HydroPWNics/SunLeaf/img/SunLeaf0.2a3D.png

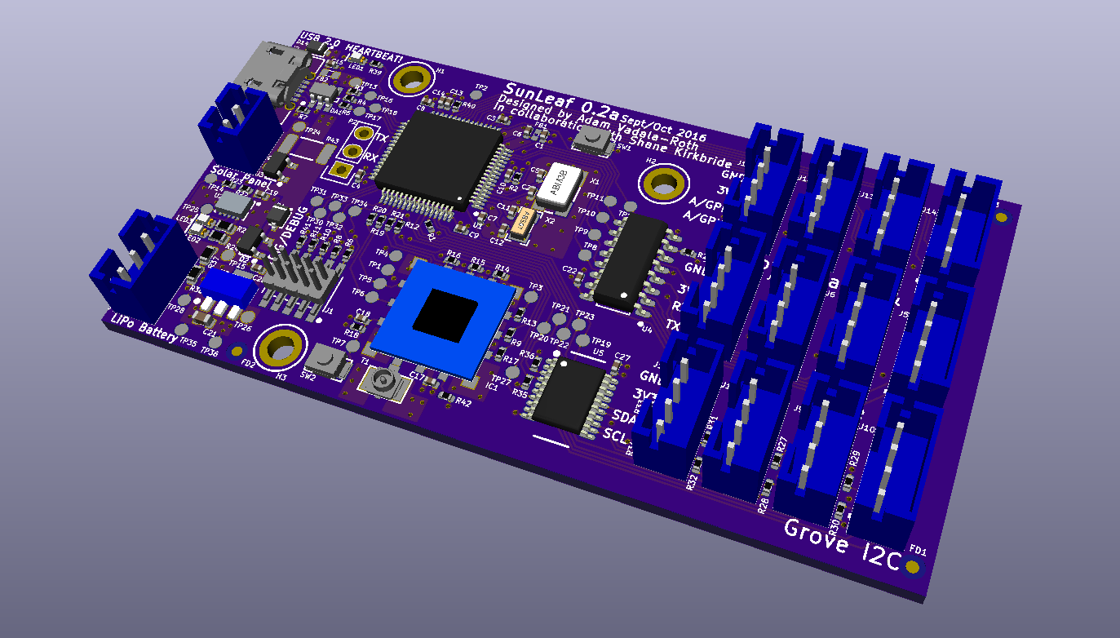
img/SunLeaf0.2a3D.png
