HydroPWNics/SunLeaf/img/SunLeaf0.1aFab.JPG

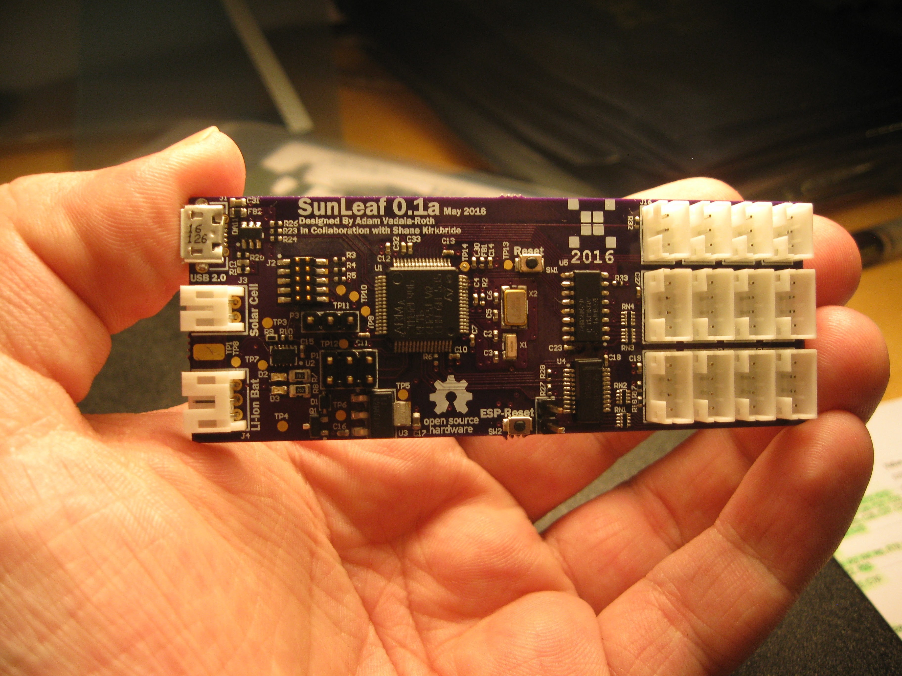
img/SunLeaf0.1aFab.JPG
