HydroPWNics/SunLeaf/README.md

# SunLeaf
SunLeaf is a WiFi based remote sensor module, interfaces with I2C and UART sensors, pushes directly to the cloud.
