HydroPWNics/SunLeaf/Datasheet/PSF-A85_Schmatic.png

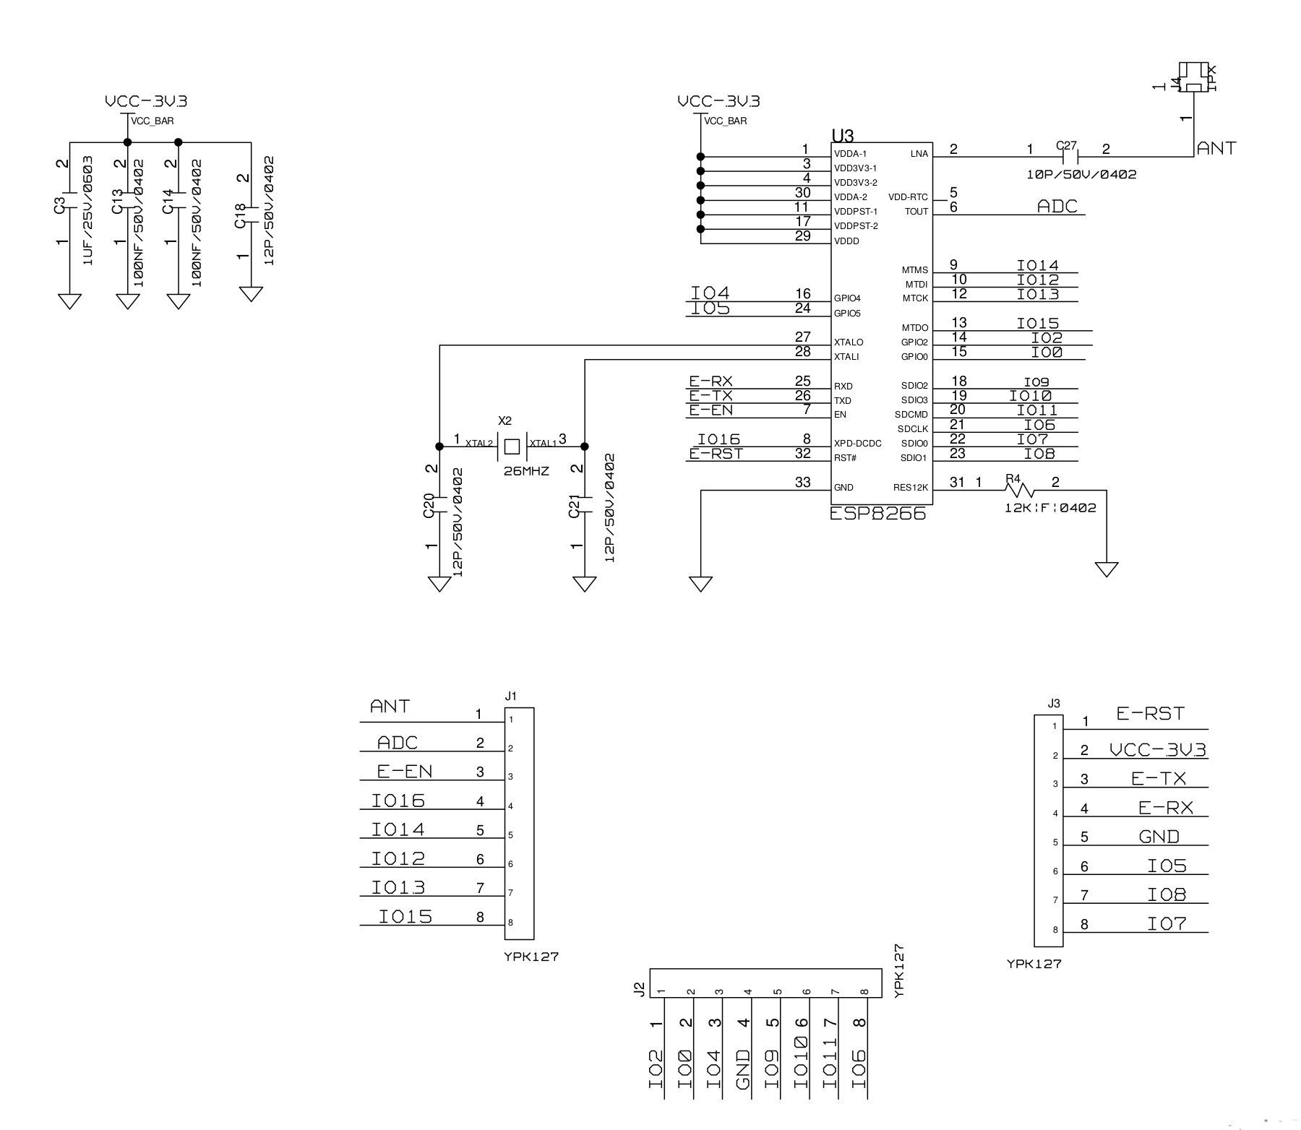
Datasheet/PSF-A85_Schmatic.png
