HydroPWNics/SunLeaf/img/IMG_3619.JPG

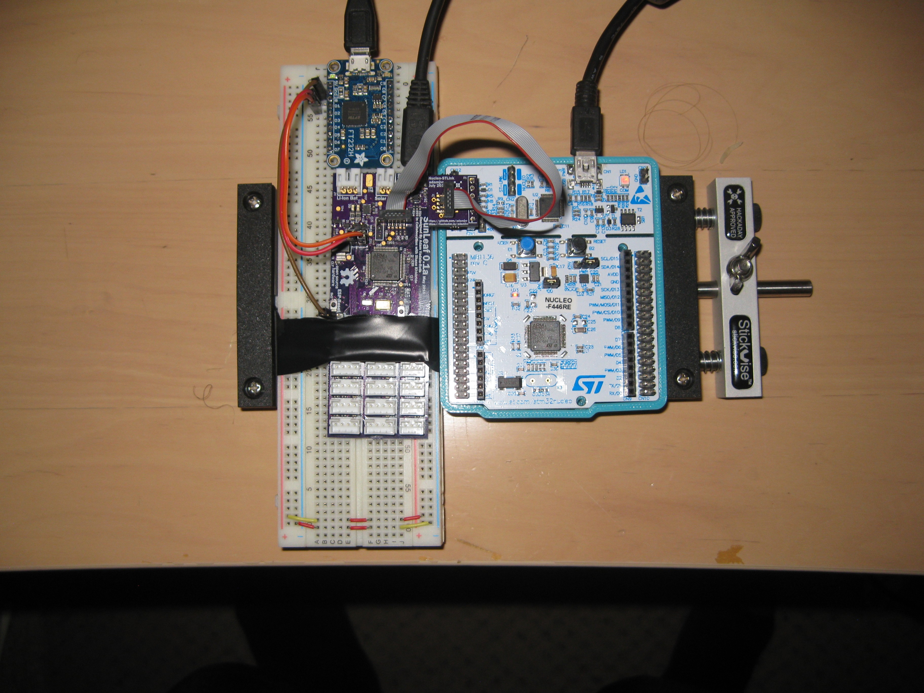
img/IMG_3619.JPG
