HydroPWNics/SunLeaf/img/SunLeaf0.1a.png

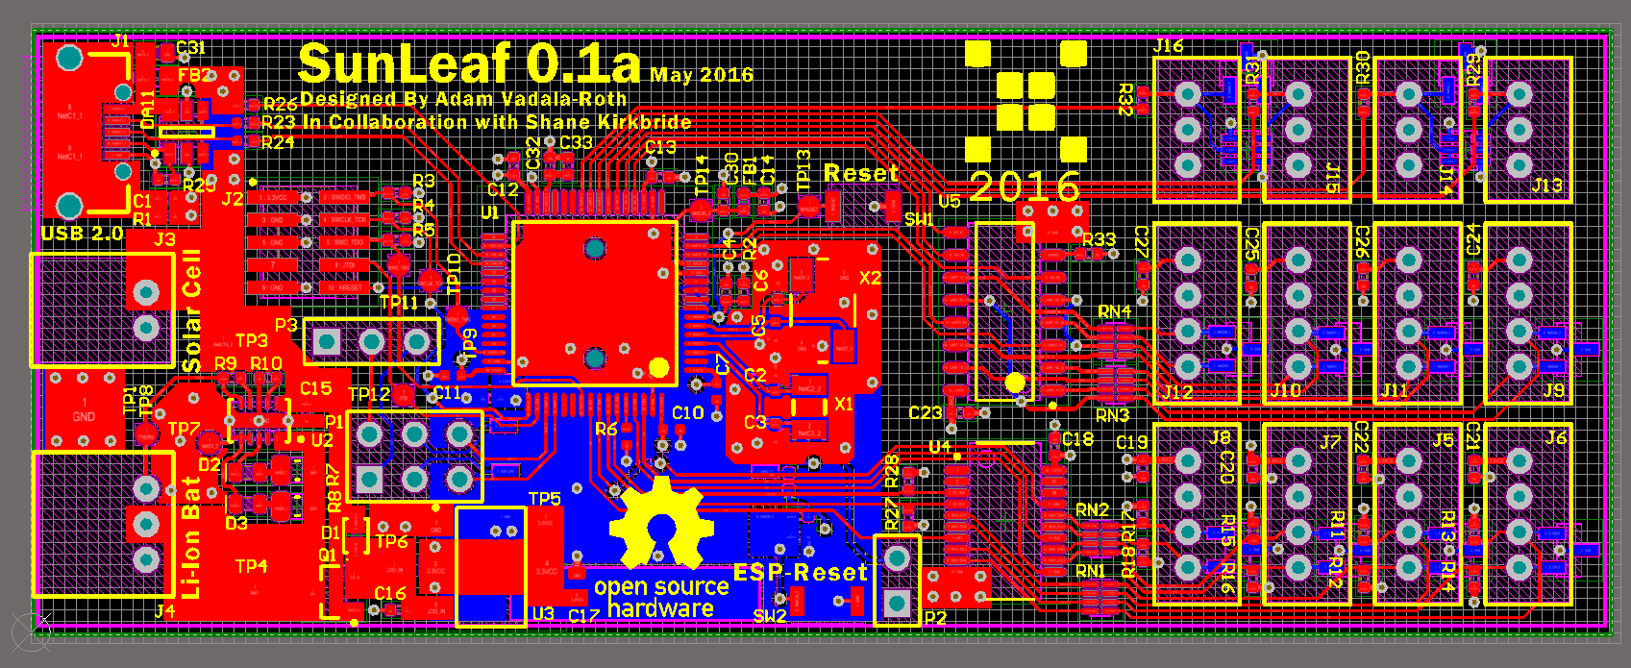
img/SunLeaf0.1a.png
