HydroPWNics/SunLeaf/img/SunLeaf0.2a2D.png

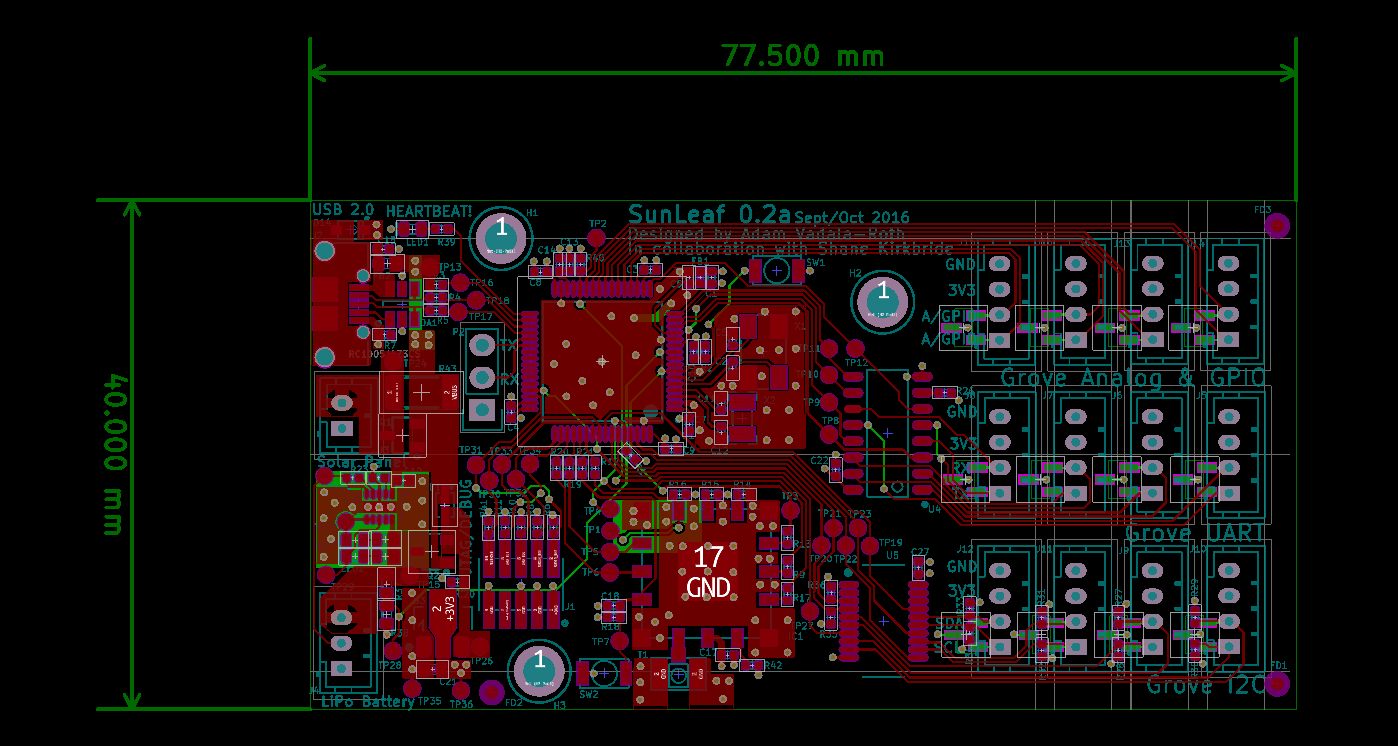
img/SunLeaf0.2a2D.png
