HydroPWNics/SunLeaf/img/SunLeaf0.2a_OSHPAR_bottom.png

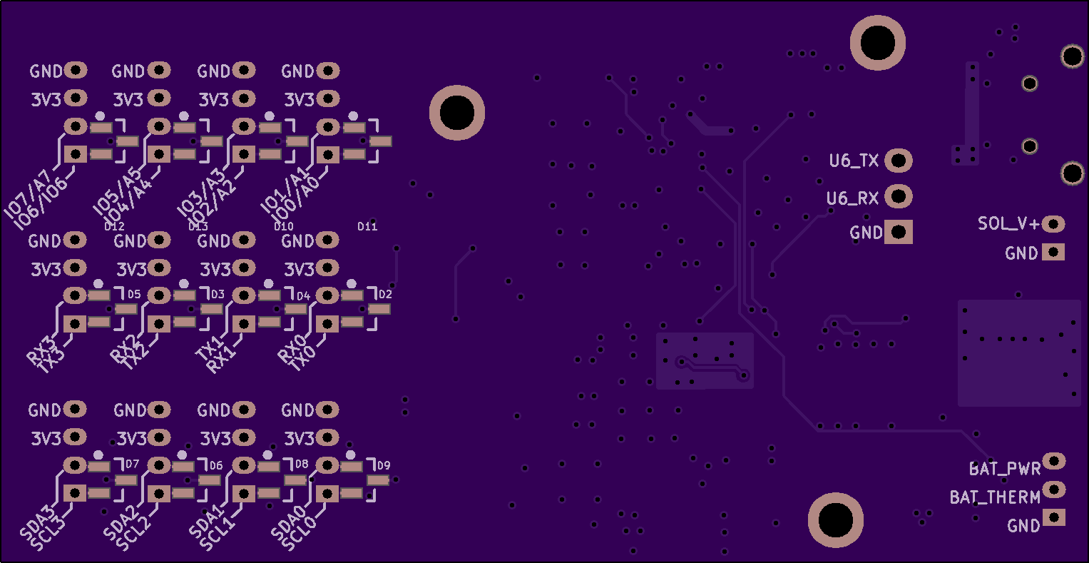
img/SunLeaf0.2a_OSHPAR_bottom.png
