HydroPWNics/SunLeaf/img/SunLeaf0.2a_OSHPAR_top.png

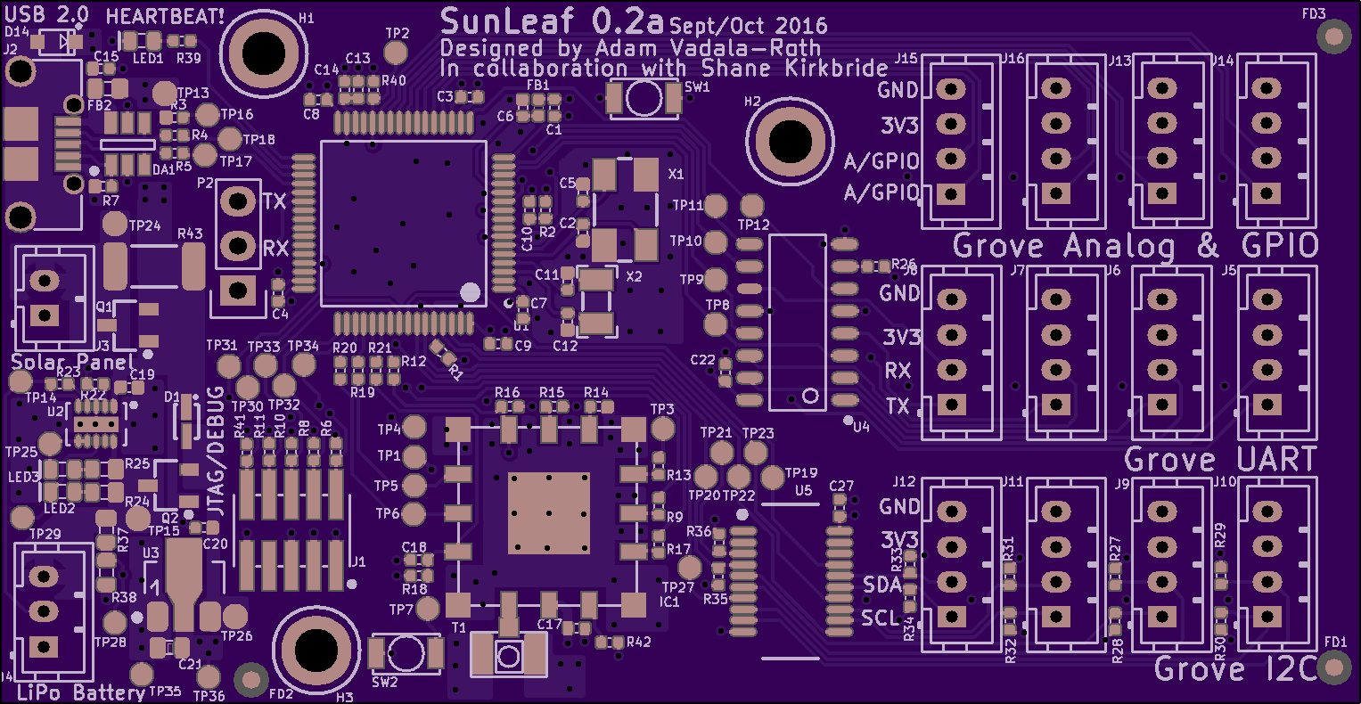
img/SunLeaf0.2a_OSHPAR_top.png
