HydroPWNics/SunLeaf/img/SunLeaf_block.png

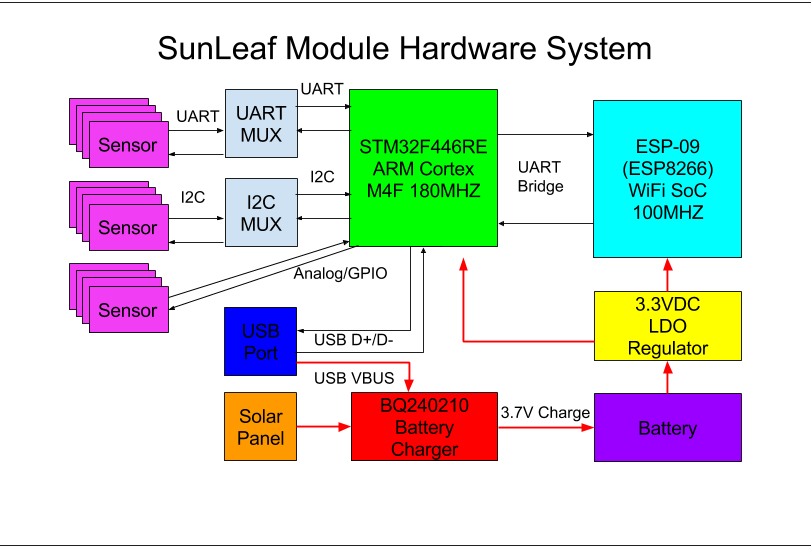
img/SunLeaf_block.png
