HydroPWNics/SunLeaf/PCB V2.1/Schematic Renders/ANA_GPIO.png

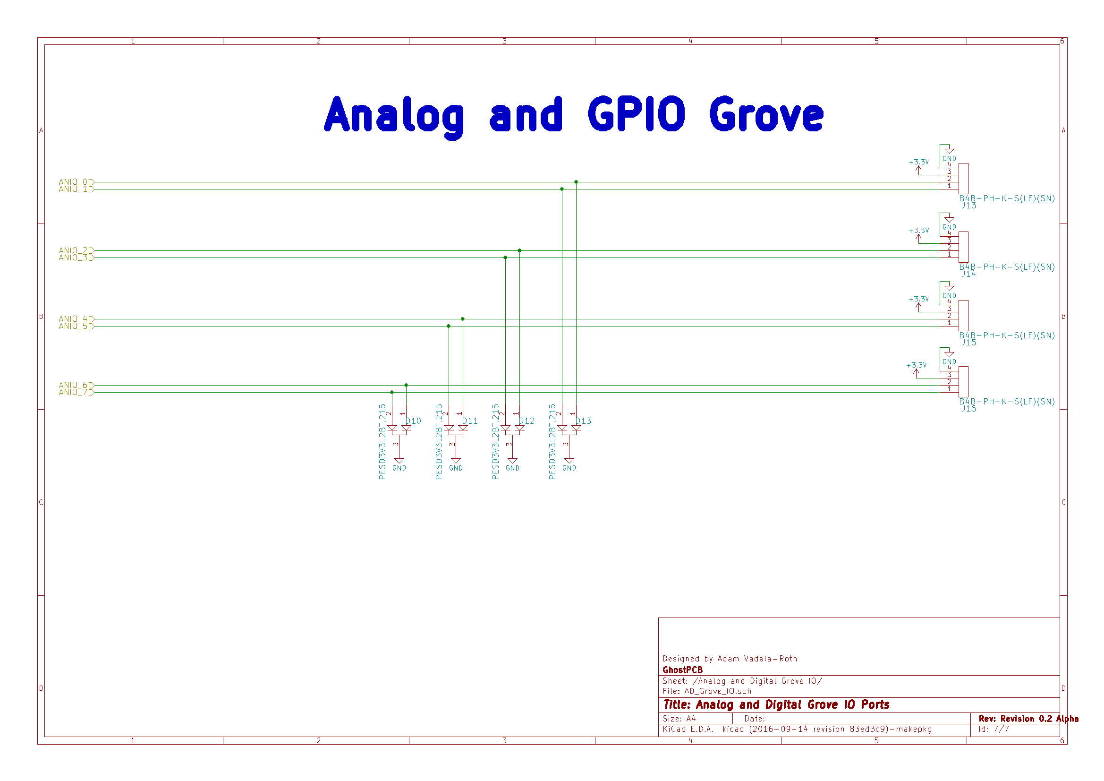
PCB V2.1/Schematic Renders/ANA_GPIO.png
