HydroPWNics/SunLeaf/PCB V2.1/Schematic Renders/BAT_PWR.png

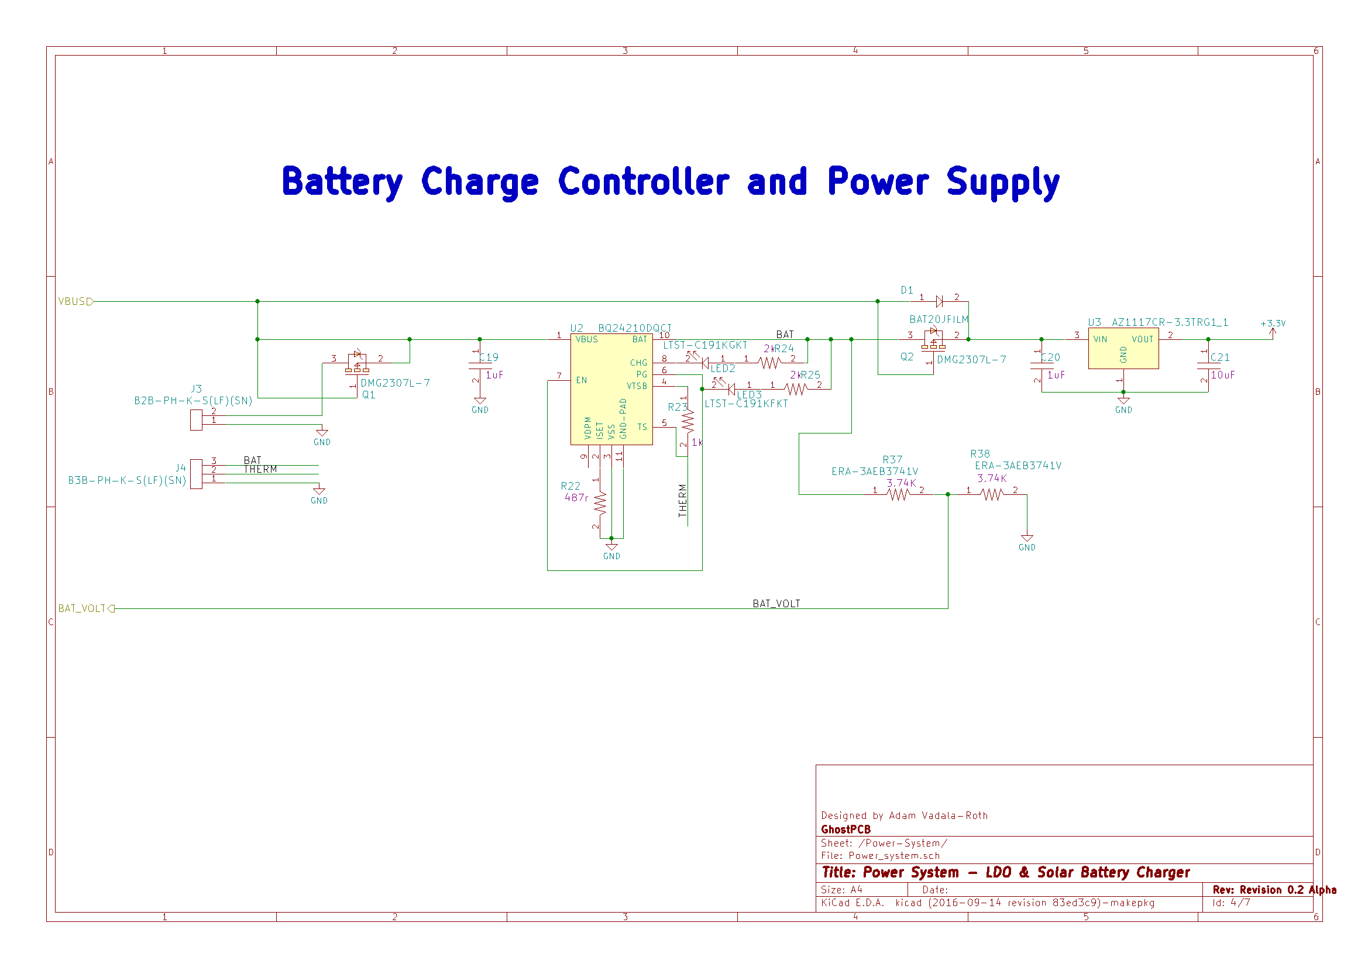
PCB V2.1/Schematic Renders/BAT_PWR.png
