HydroPWNics/SunLeaf/PCB V2.1/Schematic Renders/ESP-09.png

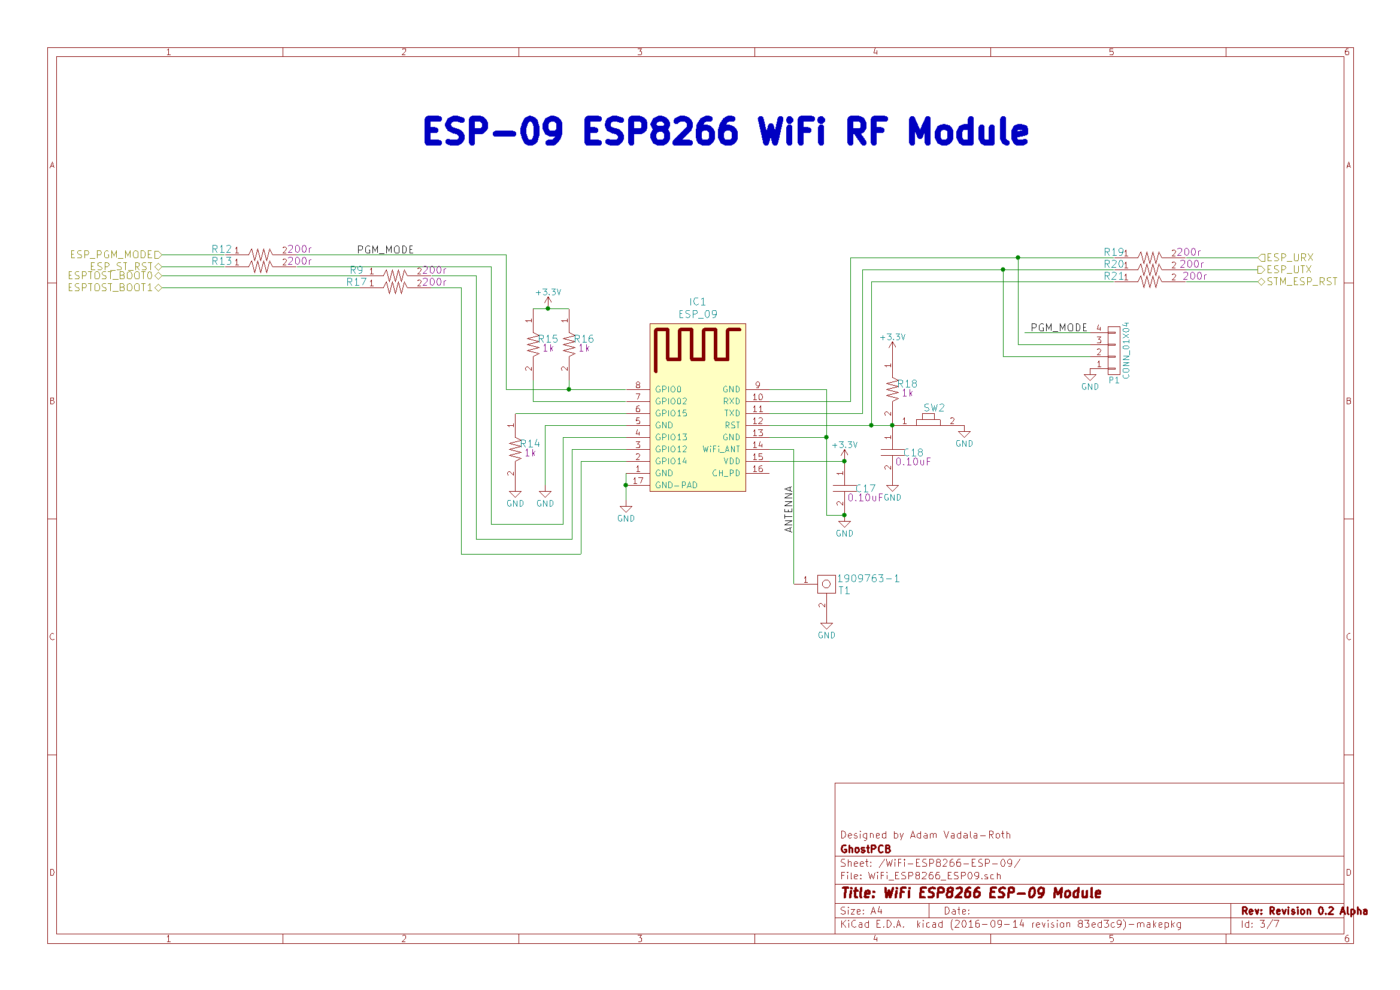
PCB V2.1/Schematic Renders/ESP-09.png
