HydroPWNics/SunLeaf/PCB V2.1/Schematic Renders/I2C_S.png

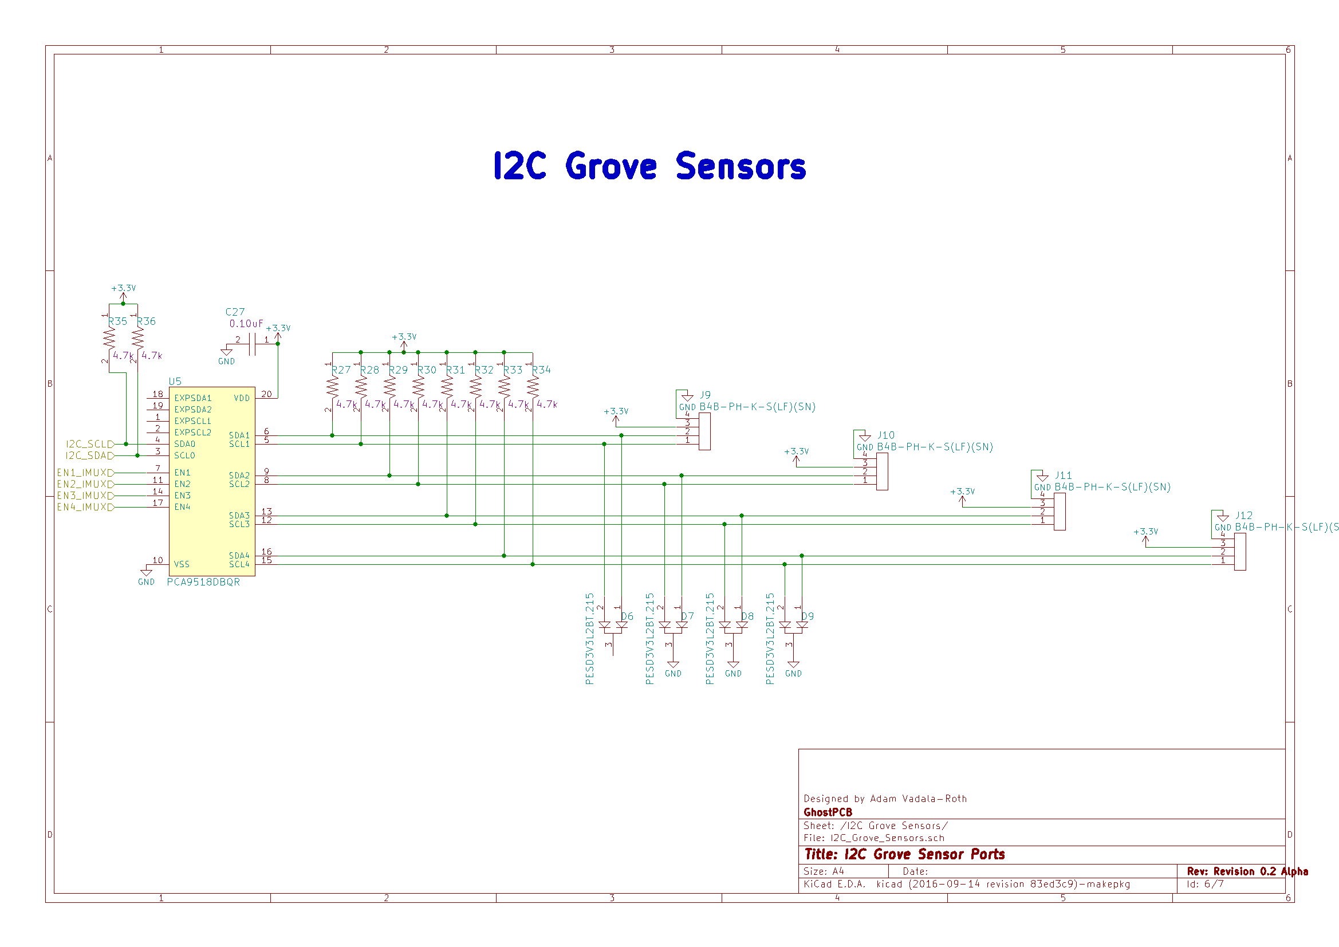
PCB V2.1/Schematic Renders/I2C_S.png
