HydroPWNics/SunLeaf/PCB V2.1/Schematic Renders/STM32.png

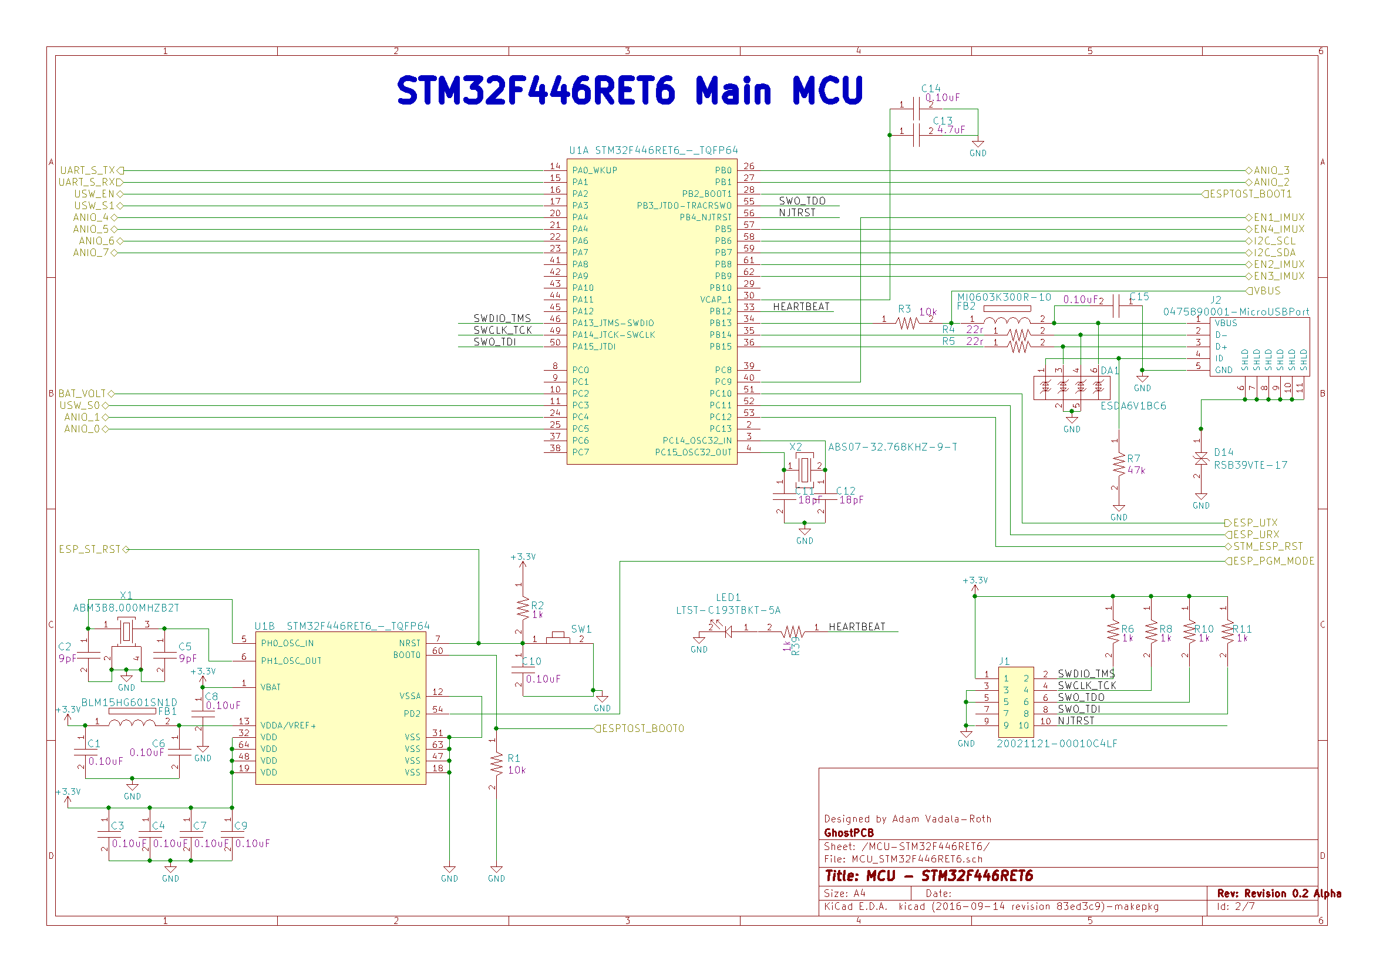
PCB V2.1/Schematic Renders/STM32.png
