HydroPWNics/SunLeaf/PCB V2.1/Schematic Renders/SystemOV.png

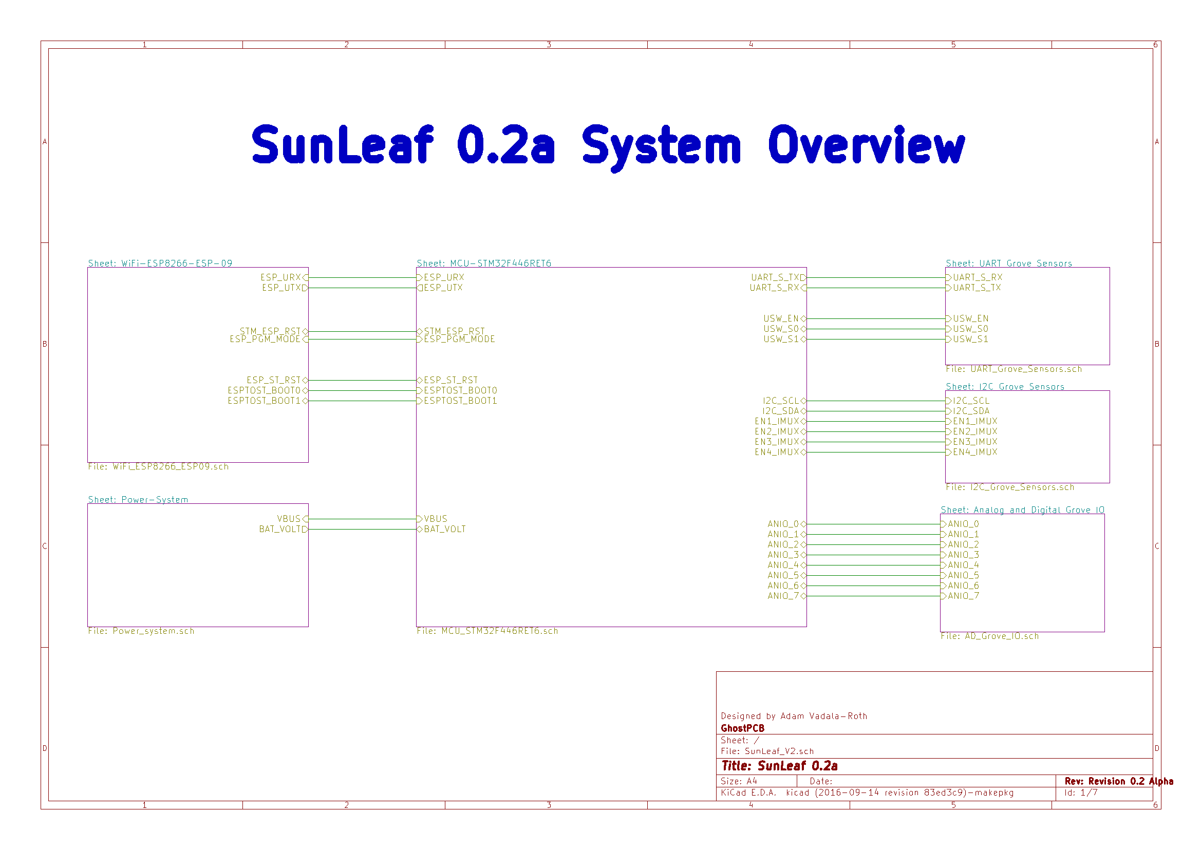
PCB V2.1/Schematic Renders/SystemOV.png
