HydroPWNics/SunLeaf/PCB V2.1/Schematic Renders/UART_S.png

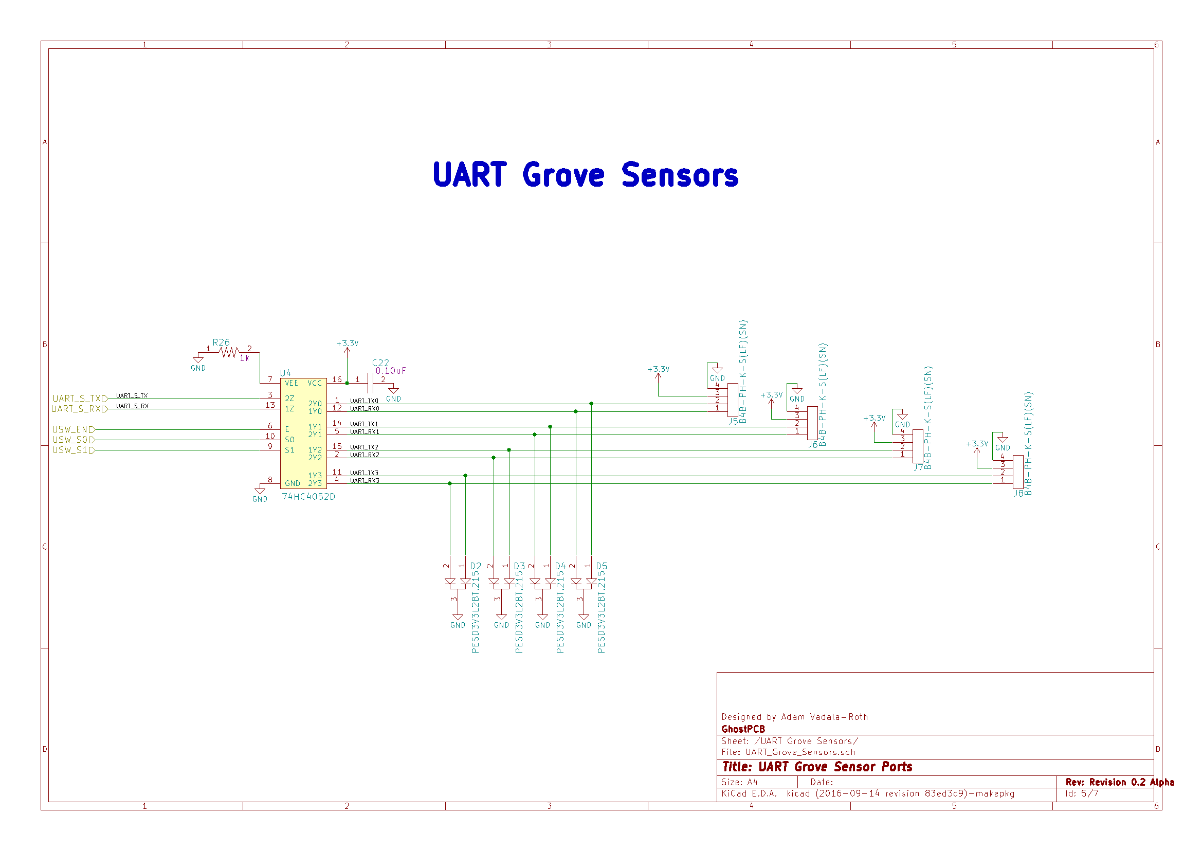
PCB V2.1/Schematic Renders/UART_S.png
