HydroPWNics/SunLeaf/(commit log)

2016-03-31 Footprints and Schematic
    Preliminary footprint creation for new MCU completed. Schematic nearly
    finished currently working on the STM32 section all others are done save
    for some ESD supression on the sensor connectors.
    [MCU - STM32F446RET6.SchDoc, Power.SchDoc, Sensors - I2C_Grove.SchDoc, Sensors - UART_Grove.SchDoc, Sensors_WiFi.SchDoc, SunLeaf.PrjPcb, System.SchDoc, WiFi - ESP8266 SoC.SchDoc]
2016-04-03 Schematic Near COmplete
    All left is connecting subsystems to STM32F4 and finishign the USB
    circuit.
    [MCU - STM32F446RET6.SchDoc, Power.SchDoc, Sensors - I2C_Grove.SchDoc, Sensors - UART_Grove.SchDoc, SunLeaf.PrjPcb, System.SchDoc, WiFi - ESP8266 SoC.SchDoc]
2016-04-07 Schematic Finished Board Started
    Schematic complete but subject to change and PCB started.
    [MCU - STM32F446RET6.SchDoc, Power.SchDoc, Sensors - I2C_Grove.SchDoc, Sensors - UART_Grove.SchDoc, SunLeaf.PcbDoc, SunLeaf.PrjPcb, System.SchDoc, WiFi - ESP8266 SoC.SchDoc]
2016-04-08 PCB Progress
    More progress on PCB, bottom mounting all ESD components on grove
    sensors.
    [MCU - STM32F446RET6.SchDoc, Sensors - I2C_Grove.SchDoc, Sensors - UART_Grove.SchDoc, SunLeaf.PcbDoc, SunLeaf.PrjPcb]
2016-04-11 Board Progress
    Board progressing along, schematic for I2C and UART connectors pin
    swapped for correct pinout.
    [Sensors - I2C_Grove.SchDoc, Sensors - UART_Grove.SchDoc, SunLeaf.PcbDoc]
2016-04-27 Board
    Lots of progress with the PCB, size increased to 1.25 X 3.5 inches to
    better fit circuitry and allow for an adequate keep out layer. Expansion
    connectors are being added but highly subject to change a few times
    before finalizing. The ESP-02 module's UART signals are jumperable to
    connect it to either the STM32 or a programming pin header. Discussing
    with Shane about further improvements and ESD suppression.
    [MCU - STM32F446RET6.SchDoc, Sensors - I2C_Grove.SchDoc, Sensors - UART_Grove.SchDoc, SunLeaf.PcbDoc, SunLeaf.PrjPcb, WiFi - ESP8266 SoC.SchDoc]
2016-04-29 Nearing COmpletion
    Added graphics for designer credit, hackaday prize, and open hardware.
    Still working out expansion headers.
    [MCU - STM32F446RET6.SchDoc, SunLeaf.PcbDoc, SunLeaf.PrjPcb]
2016-05-02 Done
    Board finished, awaiting discussion with Shane
    [Expansion & Analog.SchDoc, MCU - STM32F446RET6.SchDoc, SunLeaf.PcbDoc, SunLeaf.PrjPcb, System.SchDoc]
2016-05-05 Board CHanges
    Shielding copper pour tied to ground for the ESP-02 module added.
    Routing adjusted and cleaned up. Alligator clip test point added for
    scope probe grounding.
    [MCU - STM32F446RET6.SchDoc, Power.SchDoc, SunLeaf.PcbDoc]
2016-05-06 Test Points and Cleanup
    Errors cleaned up (unrouted nets etc), test points added. More to
    follow.
    [Expansion & Analog.SchDoc, MCU - STM32F446RET6.SchDoc, Power.SchDoc, Sensors - I2C_Grove.SchDoc, Sensors - UART_Grove.SchDoc, SunLeaf.PcbDoc, WiFi - ESP8266 SoC.SchDoc]
2016-05-09 Schematic Review and Change
    Shematic went under futher review, additional cap added to VCAP pin and
    other pins tied GND instead of though caps, misunderstanding of the
    Nucleo schematic vs. datasheet spec.
    [MCU - STM32F446RET6.SchDoc, SunLeaf.PcbDoc]
2016-05-24 Design Finished and Off To Fab
    Design now frozen in place for prototype 1 fabrication, assembly and
    test. The libraries saw a massive cleanup, the USB section redesigned
    with the correct signal order! 3D step file included, and OSHPark order
    files.
    [MCU - STM32F446RET6.SchDoc, Power.SchDoc, Sensors - I2C_Grove.SchDoc, Sensors - UART_Grove.SchDoc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]
2016-06-05 3D Fixes
    Component with incorrect Z axis offset, fixed and 3D model accurately
    regenerated.
    [SunLeaf.PcbDoc, WiFi - ESP8266 SoC.SchDoc]
2016-08-08 Nucleo-STLink
    fully completed project for a PCB adapter for the ST Nucleo board's
    programming header. adapts the 6 pin SWD header to a ARM Cortex M debug
    header.
    [Nucleo-STLink.PcbDoc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]
2016-08-22 V2 begun
    Version 2 and KiCAD port started
    [AD_Grove_IO.sch, Expansion & Analog.SchDoc, I2C_Grove_Sensors.sch, MCU - STM32F446RET6.SchDoc, MCU_STM32F446RET6.sch, Power.SchDoc, Power_system.sch, SunLeaf.PcbDoc]
2016-09-09 SunLeaf Alpha 0.2 and KiCAD Port
    SunLeaf rev 2 called Alhpa 0.2 or 0.2a is the main component of this
    commit. The entire hardware project has been ported to KiCAD libaries
    and all. 0.2a features a revised formfactor, better ESP module, and many
    fixes over the original. This version will also be capable of OTA
    updates.
    [AD_Grove_IO.sch, Expansion & Analog.SchDoc, I2C_Grove_Sensors.sch, MCU - STM32F446RET6.SchDoc, MCU_STM32F446RET6.sch, Power.SchDoc, Power_system.sch, SunLeaf.PcbDoc]
2016-09-09 Update
    Updating KiCAD to the latest to get rounded corner pad support, filing
    this commit as a backup of the project before update.
    [AD_Grove_IO.sch, I2C_Grove_Sensors.sch, MCU_STM32F446RET6.sch, Power_system.sch, UART_Grove_Sensors.sch, WiFi_ESP8266_ESP09.sch]
2016-09-17 Placement
    Heavy progress on component placement in KiCAD for SunLEaf V2,
    committing to save progress, nightly builds of KiCAD are very crash
    prone.
    [AD_Grove_IO.sch, I2C_Grove_Sensors.sch, MCU_STM32F446RET6.sch, Power_system.sch, SunLeaf_V2.kicad_pcb, UART_Grove_Sensors.sch, WiFi_ESP8266_ESP09.sch, _saved_AD_Grove_IO.sch]
2016-09-17 Placement near completeq
    placement is near complete, saving as revision, remember KiCAD=crash
    [AD_Grove_IO.sch, I2C_Grove_Sensors.sch, UART_Grove_Sensors.sch, _saved_AD_Grove_IO.sch, _saved_I2C_Grove_Sensors.sch]
2016-09-17 Revert "Placement near completeq"
    This reverts commit ae7bce2a0b52adb9ec10d03d9117548a28df5835.
    [SunLeaf_V2.kicad_pcb, UART_Grove_Sensors.sch, _saved_AD_Grove_IO.sch, _saved_I2C_Grove_Sensors.sch]
2016-09-17 Placement progress
    Placement is 99% done board is being resized. Next commit TVS diode
    pairs will be fliped and the baord further resized.
    [AD_Grove_IO.sch, I2C_Grove_Sensors.sch, SunLeaf_V2.kicad_pcb, UART_Grove_Sensors.sch]
2016-09-17 Routing and Placement
    Placement complete routing has begun. The board size has also been
    solidified.
    [MCU_STM32F446RET6.sch, SunLeaf_V2.kicad_pcb, _saved_AD_Grove_IO.sch, _saved_I2C_Grove_Sensors.sch]
2016-09-17 Routing Progress
    Routing progress made, UART and I2C sensors routed, ESP routed, power
    section and solar batter routed, USB routed.
    [MCU_STM32F446RET6.sch, SunLeaf_V2.kicad_pcb, UART_Grove_Sensors.sch]
2016-09-17 Route 99%
    PCB routing at 99%, next commit complete route and internal layers.
    [SunLeaf_V2.kicad_pcb]
2016-09-17 Internal Planes
    Internal Planes added, small amount of routing left.
    [AD_Grove_IO.sch, I2C_Grove_Sensors.sch, MCU_STM32F446RET6.sch, Power_system.sch, SunLeaf_V2.kicad_pcb, SunLeaf_V2.sch, UART_Grove_Sensors.sch, WiFi_ESP8266_ESP09.sch]
2016-09-17 PDF
    Schematic PDF updated.
    [SunLeaf_V2.kicad_pcb]
2016-09-18 Workstation Switch
    Switching to laptop, syncing files.
    [SunLeaf_V2.kicad_pcb]
2016-09-19 OTA
    This commit contains adjustments to the schematics for over the air
    update/programming of STM32 via the ESP8266 using its internal
    bootloader. The two processors have been wired together to suppor this
    fucntions, they can toggle reset of eachother and load firmware over
    UART. Still deciding what reset signal pin on the STM32 to use fo rthis
    purpose, next commit.
    [AD_Grove_IO.sch, I2C_Grove_Sensors.sch, MCU_STM32F446RET6.sch, Power_system.sch, SunLeaf_V2.kicad_pcb, SunLeaf_V2.sch, UART_Grove_Sensors.sch, WiFi_ESP8266_ESP09.sch]
2016-09-19 Battery Monitoring & OTA
    OTA signals between both processors solidified and routed. Battery
    monitoring added as voltage divider into ADC channel. All but done
    pending some small tweaks.
    [AD_Grove_IO.sch, I2C_Grove_Sensors.sch, MCU_STM32F446RET6.sch, Power_system.sch, SunLeaf_V2.sch, UART_Grove_Sensors.sch, WiFi_ESP8266_ESP09.sch]
2016-09-21 App Notes
    App notes added to datasheets folder.
    [AD_Grove_IO.sch, I2C_Grove_Sensors.sch, MCU_STM32F446RET6.sch, Power_system.sch, SunLeaf_V2.kicad_pcb, UART_Grove_Sensors.sch, WiFi_ESP8266_ESP09.sch]
2016-09-23 DRC Clearing
    More DRC errors cleared. Getting board ready for fab.
    [AD_Grove_IO.sch, I2C_Grove_Sensors.sch, MCU_STM32F446RET6.sch, Power_system.sch, SunLeaf_V2.kicad_pcb, UART_Grove_Sensors.sch, WiFi_ESP8266_ESP09.sch]
2016-09-26 DRC clear
    all design rule violations cleared.
    [MCU_STM32F446RET6.sch, SunLeaf_V2.kicad_pcb]
2016-09-29 3D and Tweaks
    3D files added for components for proper 3D rneder of the board. Board
    tweaked, additional ground pours and sticking under neath the ESP-09,
    cleaned up routign of JTAG , added labeling of all the pin signals.
    [AD_Grove_IO.sch, I2C_Grove_Sensors.sch, MCU_STM32F446RET6.sch, Power_system.sch, SunLeaf_V2.kicad_pcb, UART_Grove_Sensors.sch, WiFi_ESP8266_ESP09.sch, _saved_WiFi_ESP8266_ESP09.sch]
2016-09-29 Repo Cleanup
    Repo cleaned up and braought up to date
    [Expansion & Analog.SchDoc, MCU - STM32F446RET6.SchDoc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]
2016-09-29 Schematic Changes
    Schematic changes saved.
    [SunLeaf_V2.kicad_pcb, _saved_WiFi_ESP8266_ESP09.sch]
2016-10-04 Test Points
    Test points added as well as some retooling of the PCB overall. More
    updates to come before the pending fab
    [AD_Grove_IO.sch, I2C_Grove_Sensors.sch, MCU_STM32F446RET6.sch, Power_system.sch, SunLeaf_V2.csv, SunLeaf_V2.kicad_pcb, UART_Grove_Sensors.sch, WiFi_ESP8266_ESP09.sch]
2016-10-04 Updated PDF
    Updated PDF of schematic indluding the newly added test points!
2016-10-05 JTAG Test Points
    Test Points added to JTAG.
    [MCU_STM32F446RET6.sch, Power_system.sch, SunLeaf_V2.kicad_pcb]
2016-10-05 Images
    Images added and organized
    [Power_system.sch, SunLeaf_V2.kicad_pcb]
2016-10-30 LDO and Switch
    LDO swapped out for one that better matches the complete system's
    amperage requirements. The LDO is now a 600mA one and has a toggle
    switch for shuttingit on and off, this will allow the SunLeaf to be
    stored and or shipped.
    [AD_Grove_IO.sch, I2C_Grove_Sensors.sch, Power_system.sch, SunLeaf_V2.csv, SunLeaf_V2.kicad_pcb, UART_Grove_Sensors.sch]
2016-11-01 Diode Error
    The pin numbering on the footprint for the diode in the LDO input source
    switching circiut was revered, it has now been adjusted to be correct.
    [SunLeaf_V2.kicad_pcb, _saved_Power_system.sch]
